theilmbh/RPiOperant/README.md

# RPiOperant
Design files for Raspberry Pi based operant conditioning system
