theilmbh/RPiOperant/panels/BackPanelRevF.pdf

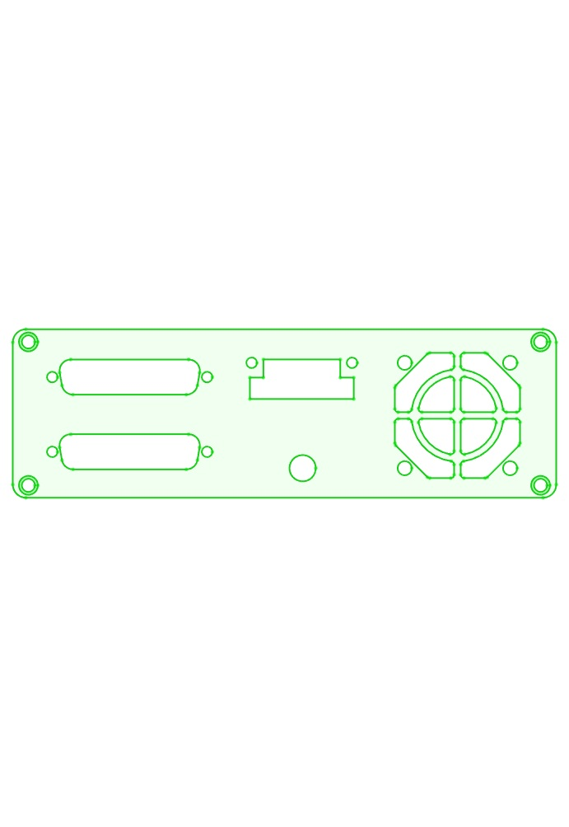
[picture p1: page 1]
