theilmbh/RPiOperant/panels/FrontPanelRevF.pdf

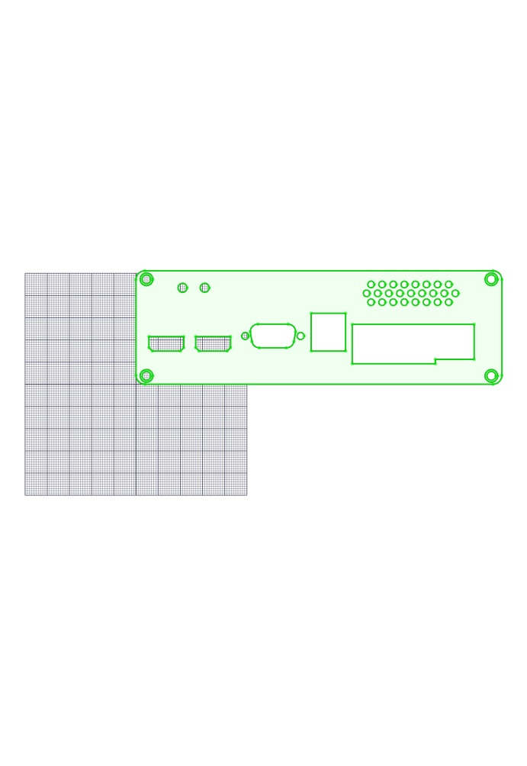
[picture p2: page 1]
