theilmbh/RPiOperant/panels/BackPanelRevF.iges

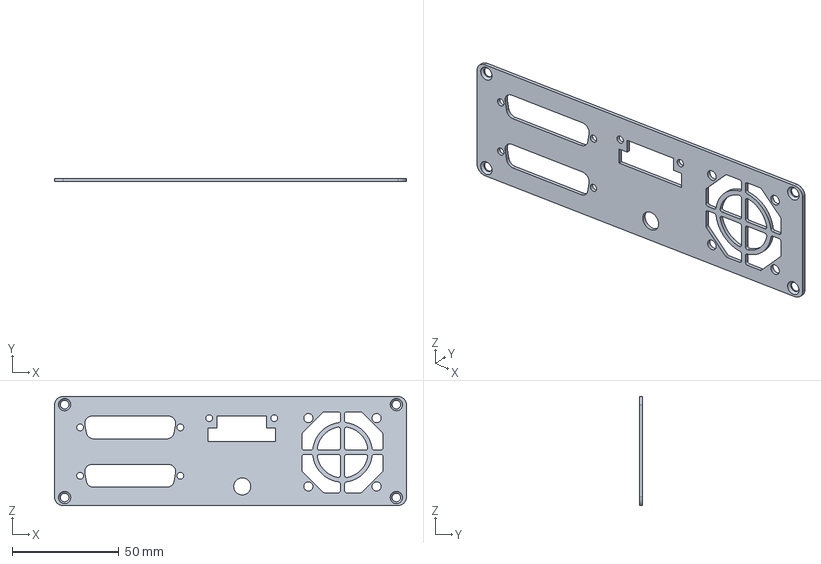
[picture p3: CAD file, 2018-11-16]
panels/BackPanelRevF.iges
165.0 x 1.50 x 51.1 mm
