theilmbh/RPiOperant/panels/FrontPanelRevF.iges

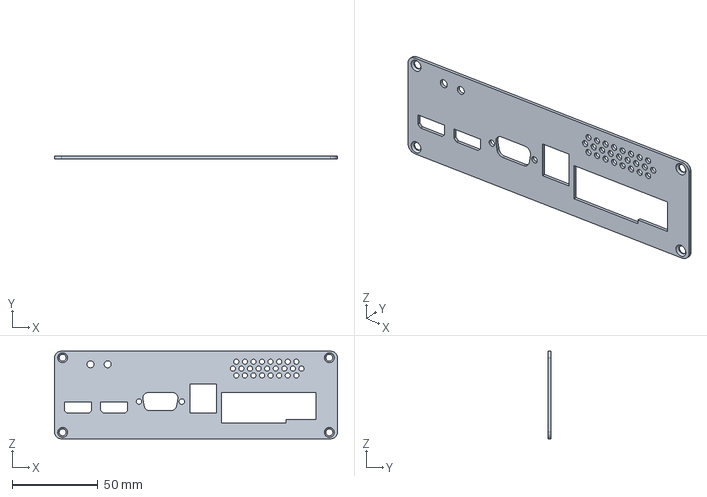
[picture p4: CAD file, 2018-11-16]
panels/FrontPanelRevF.iges
165.0 x 1.50 x 51.1 mm
