theilmbh/RPiOperant/(list of files, cad)

Other CAD files:
panels/RPiOperantFrontPanelRevF.fcstd
panels/RPiOperantBackPanelRevF.fcstd
panels/RPiOperantFrontPanelRevE.fcstd
panels/RPiOperantBackPanelRevE.fcstd
panels/RPiOperantBackPanelRevE.iges
panels/RPiOperantFrontPanelRevE.iges
