theilmbh/RPiOperant/(threads)

Thread 1 (2019-01-18):

Possible wrong item

dbals, 2019-01-18:
In the Digi-Key Cart

13	2	445-173377-1-ND	FG24X7R1H224KNT06	CAP CER 0.22UF 50V X7R RADIAL

I believe it should be:  qty 2 ‎490-11888-ND   RCER71H106MWK1H03B CAP CER 10UF 50V X7R RADIAL
