theilmbh/RPiOperant/schematics/mainboard/RPiOperant.brd

## EAGLE design schematics/mainboard/RPiOperant.brd (2018-11-14)

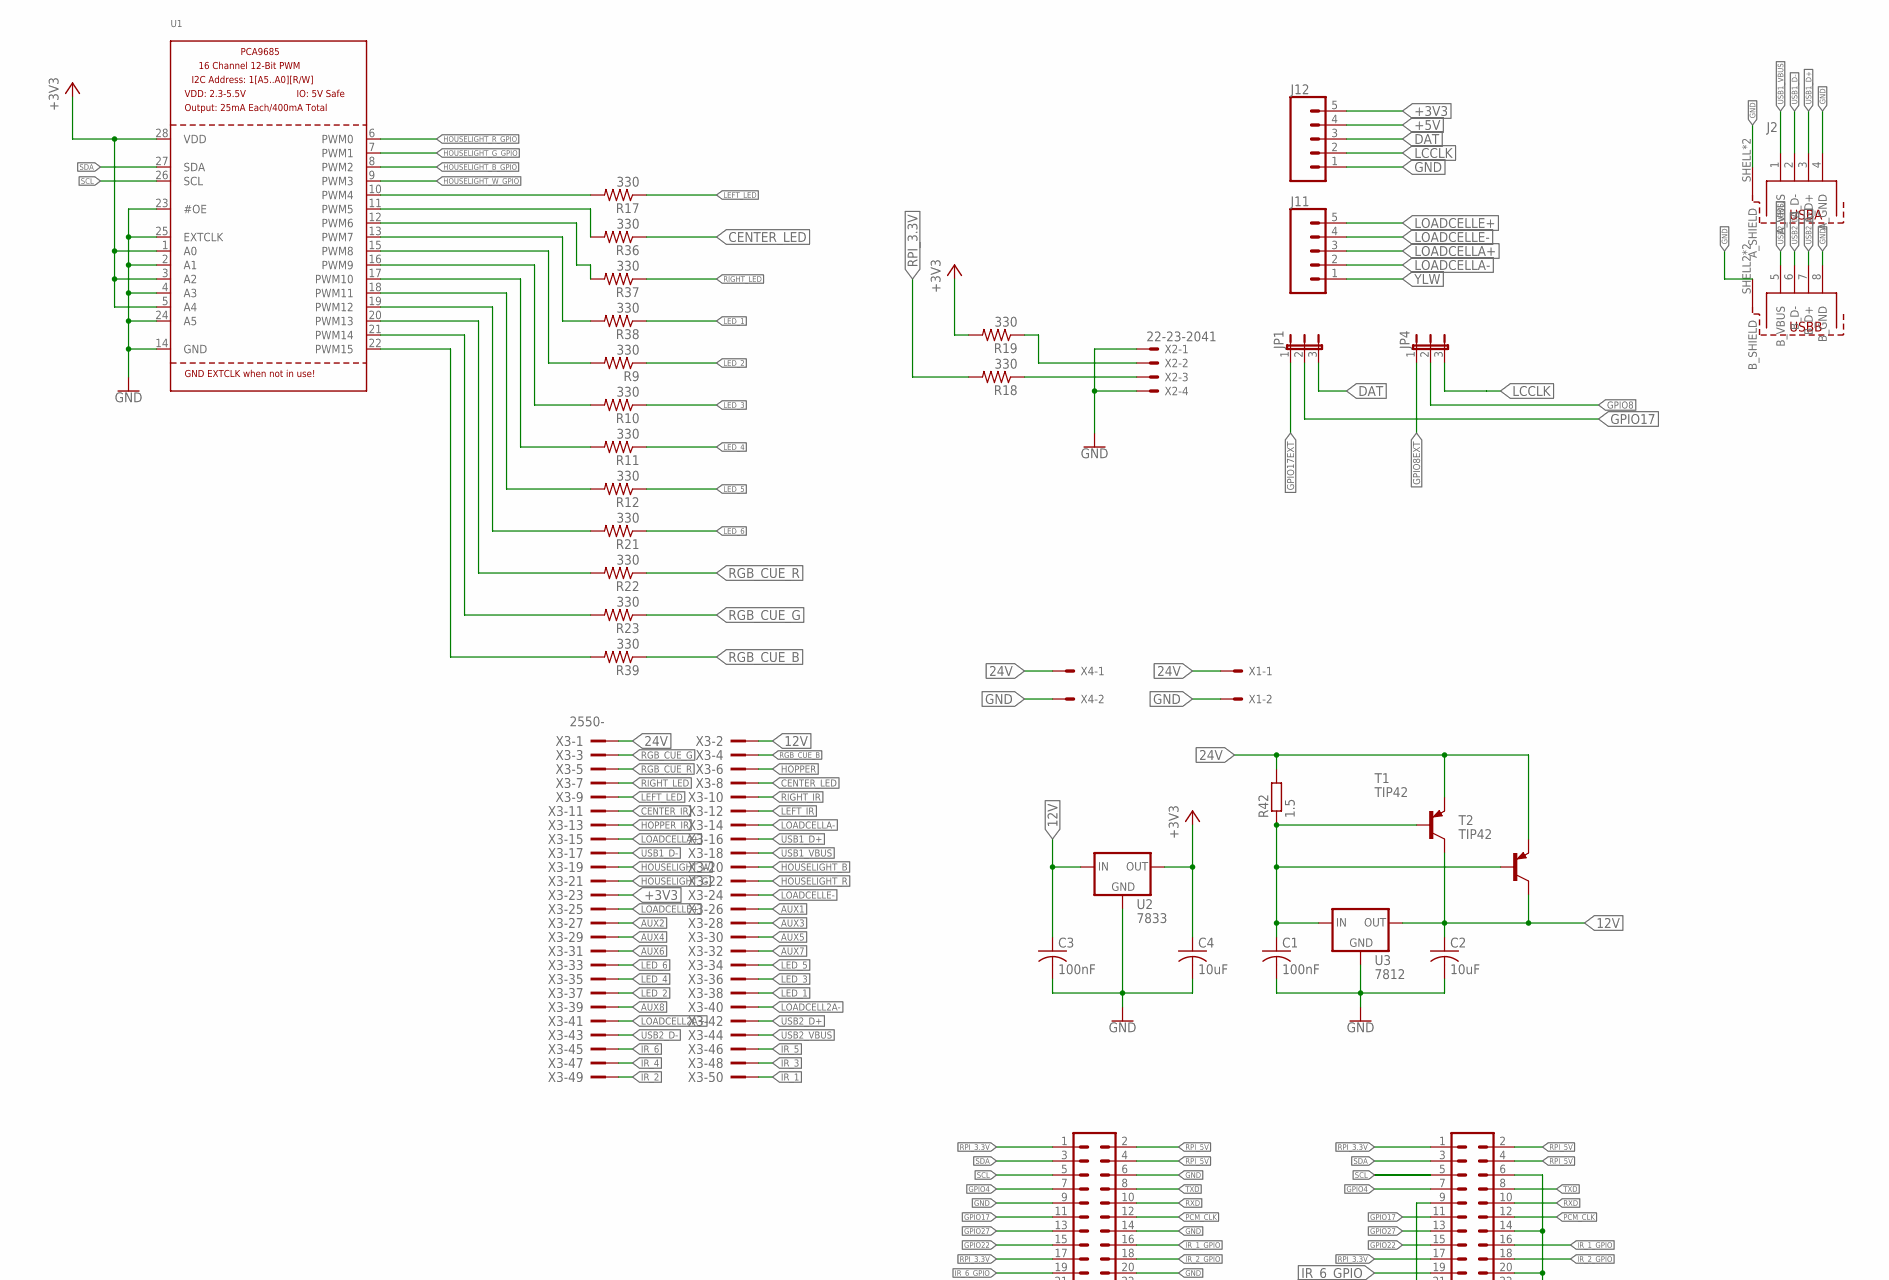
[picture p12: schematic RPiOperant.sch, sheet 1, part in row 1, column 1]

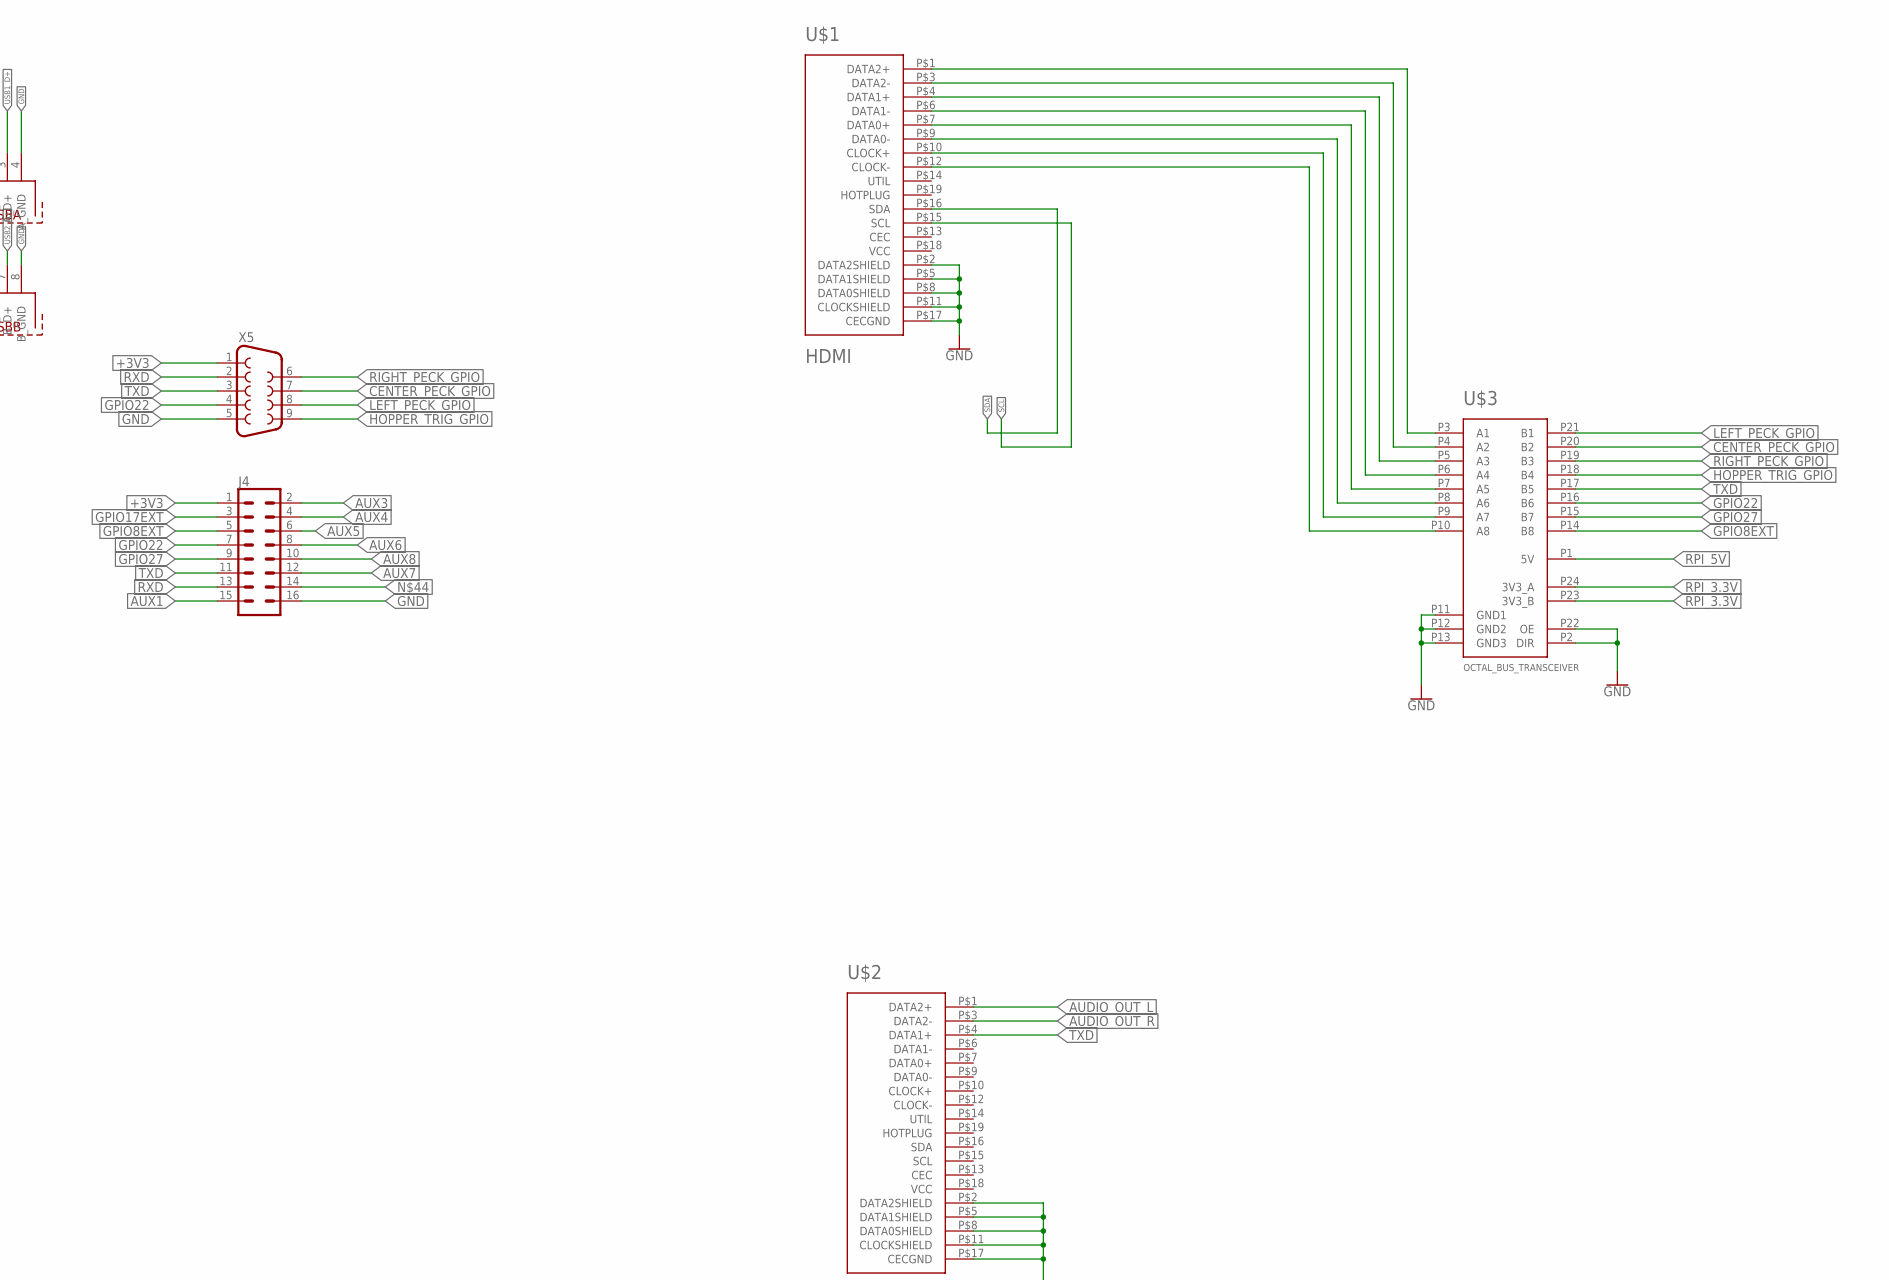
[picture p13: schematic RPiOperant.sch, sheet 1, part in row 1, column 2]

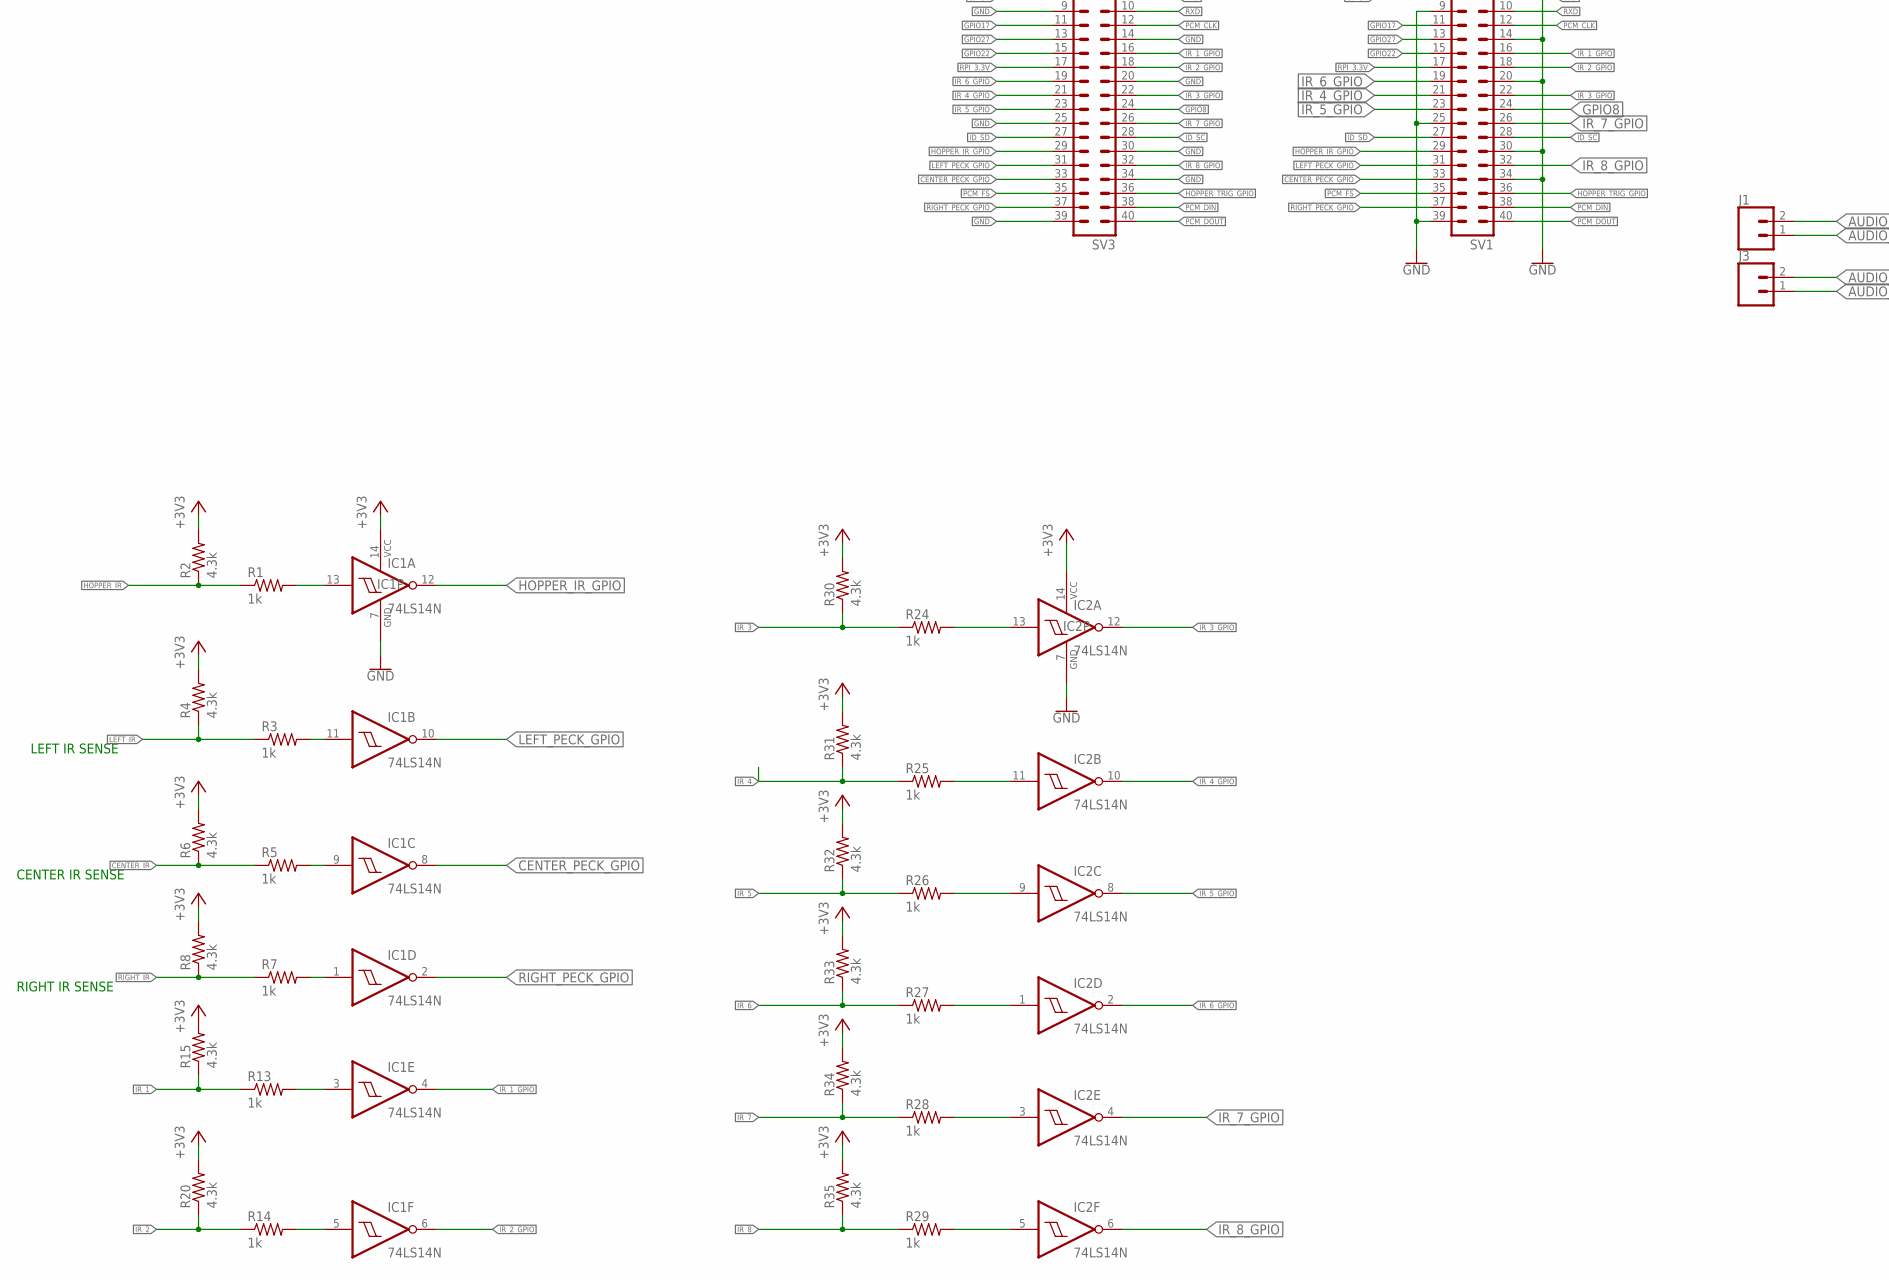
[picture p14: schematic RPiOperant.sch, sheet 1, part in row 2, column 1]

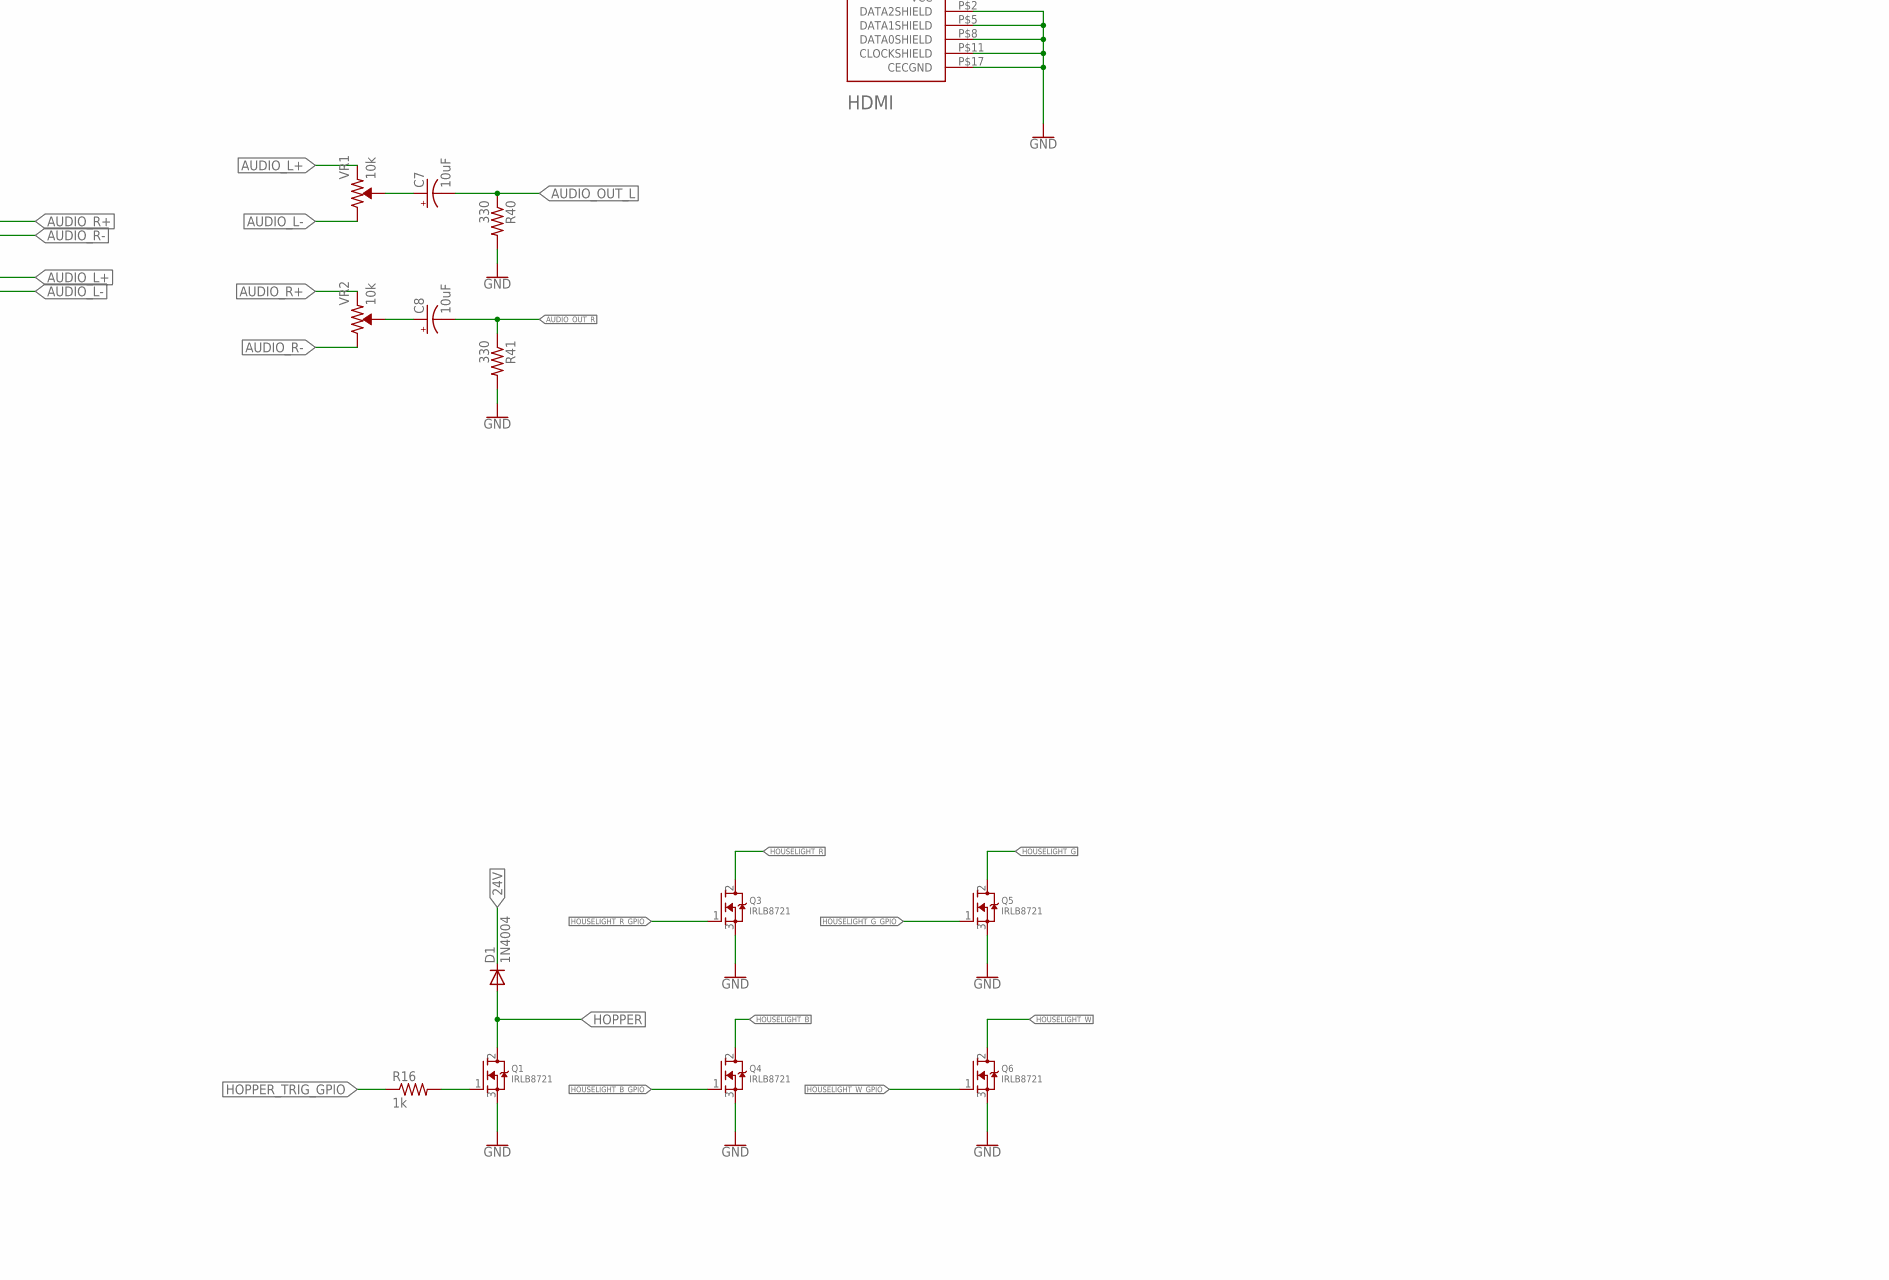
[picture p15: schematic RPiOperant.sch, sheet 1, part in row 2, column 2]

Parts:
C1, C3: 100nF; C050-025X075
C2, C4: 10uF; C050-025X075
C7, C8: 10uF; CPOL-RADIAL-2.5MM-5MM
D1: 1N4004; DO41-10
IC1, IC2: 74LS14N; DIL14
J1, J3: CONN_02POLAR_LOCK; MOLEX-1X2_LOCK
J2: 61400826021
J4: CONN_08X2; 2X8
J11, J12: CONN_05; 1X05
JP1, JP4: JP2E; JP2
Q1, Q3, Q4, Q5, Q6: IRLB8721; TO220V
R1, R3, R5, R7, R13, R14, R16, R24, R25, R26, R27, R28, R29: 1k; 0207/7
R2, R4, R6, R8, R15, R20, R30, R31, R32, R33, R34, R35: 4.3k; 0207/7
R9, R10, R11, R12, R17, R18, R19, R21, R22, R23, R36, R37, R38, R39, R40, R41: 330; 0207/7
R42: 1.5; 0411/15
SV1, SV3: MA20-2
T1, T2: TIP42; TO220V
U1: PCA9685; TSSOP28
U2: 7833; TO220-IGO
U3: 7812; TO220-IGO
U$1, U$2: HDMI; HDMI_A
U$3: OCTAL_BUS_TRANSCEIVER; TSSOP-24
VR1, VR2: 10k; TRIMPOT-PTH-3386U
X1, X4: KK-156-2
X2: 22-23-2041
X3: 2550-; PAK100/2500-50
X5: F09HP

Connections:
12V: C2.1, C3.1, T1.2 (C), T2.2 (C), U2.IN, U3.OUT, X3.2
24V: D1.C, R42.2, T1.3 (E), T2.3 (E), X1.1, X3.1, X4.1
+3V3: C4.1, IC1.14 (VCC), IC2.14 (VCC), J4.1, J12.5, R2.2, R4.2, R6.2, R8.2, R15.2, R19.2, R20.2, R30.2, R31.2, R32.2, R33.2, R34.2, R35.2, U1.1 (A0), U1.3 (A2), U1.5 (A4), U1.28 (VDD), U2.OUT, X3.23, X5.1
+5V: J12.4
AUDIO_L+: J3.2, VR1.1 (CCW)
AUDIO_L-: J3.1, VR1.3 (CW)
AUDIO_OUT_L: C7.2 (-), R40.1, U$2.P$1 (DATA2+)
AUDIO_OUT_R: C8.2 (-), R41.1, U$2.P$3 (DATA2-)
AUDIO_R+: J1.2, VR2.1 (CCW)
AUDIO_R-: J1.1, VR2.3 (CW)
AUX1: J4.15, X3.26
AUX2: X3.27
AUX3: J4.2, X3.28
AUX4: J4.4, X3.29
AUX5: J4.6, X3.30
AUX6: J4.8, X3.31
AUX7: J4.12, X3.32
AUX8: J4.10, X3.39
CENTER_IR: R5.1, R6.1, X3.11
CENTER_LED: R36.1, X3.8
CENTER_PECK_GPIO: IC1.8 (O), SV1.33, SV3.33, U$3.P20 (B2), X5.7
DAT: J12.3, JP1.3
GND: C1.2, C2.2, C3.2, C4.2, IC1.7 (GND), IC2.7 (GND), J2.4 (A_GND), J2.8 (B_GND), J2.SHELL (A_SHIELD), J2.SHELL1 (A_SHIELD), J2.SHELL2 (B_SHIELD), J2.SHELL3 (B_SHIELD), J4.16, J12.1, Q1.3 (S), Q3.3 (S), Q4.3 (S), Q5.3 (S), Q6.3 (S), R40.2, R41.2, SV1.6, SV1.9, SV1.14, SV1.20, SV1.25, SV1.30, SV1.34, SV1.39, SV3.6, SV3.9, SV3.14, SV3.20, SV3.25, SV3.30, SV3.34, SV3.39, U1.2 (A1), U1.4 (A3), U1.14 (GND), U1.23 (#OE), U1.24 (A5), U1.25 (EXTCLK), U2.GND, U3.GND, U$1.P$2 (DATA2SHIELD), U$1.P$5 (DATA1SHIELD), U$1.P$8 (DATA0SHIELD), U$1.P$11 (CLOCKSHIELD), U$1.P$17 (CECGND), U$2.P$2 (DATA2SHIELD), U$2.P$5 (DATA1SHIELD), U$2.P$8 (DATA0SHIELD), U$2.P$11 (CLOCKSHIELD), U$2.P$17 (CECGND), U$3.P2 (DIR), U$3.P11 (GND1), U$3.P12 (GND2), U$3.P13 (GND3), U$3.P22 (OE), X1.2, X2.1, X2.4, X4.2, X5.5
GPIO4: SV1.7, SV3.7
GPIO8: JP4.2, SV1.24, SV3.24
GPIO8EXT: J4.5, JP4.1, U$3.P14 (B8)
GPIO17: JP1.2, SV1.11, SV3.11
GPIO17EXT: J4.3, JP1.1
GPIO22: J4.7, SV1.15, SV3.15, U$3.P16 (B6), X5.4
GPIO27: J4.9, SV1.13, SV3.13, U$3.P15 (B7)
HOPPER: D1.A, Q1.2 (D), X3.6
HOPPER_IR: R1.1, R2.1, X3.13
HOPPER_IR_GPIO: IC1.12 (O), SV1.29, SV3.29
HOPPER_TRIG_GPIO: R16.1, SV1.36, SV3.36, U$3.P18 (B4), X5.9
HOUSELIGHT_B: Q4.2 (D), X3.20
HOUSELIGHT_B_GPIO: Q4.1 (G), U1.8 (PWM2)
HOUSELIGHT_G: Q5.2 (D), X3.21
HOUSELIGHT_G_GPIO: Q5.1 (G), U1.7 (PWM1)
HOUSELIGHT_R: Q3.2 (D), X3.22
HOUSELIGHT_R_GPIO: Q3.1 (G), U1.6 (PWM0)
HOUSELIGHT_W: Q6.2 (D), X3.19
HOUSELIGHT_W_GPIO: Q6.1 (G), U1.9 (PWM3)
ID_SC: SV1.28, SV3.28
ID_SD: SV1.27, SV3.27
IR_1: R13.1, R15.1, X3.50
IR_1_GPIO: IC1.4 (O), SV1.16, SV3.16
IR_2: R14.1, R20.1, X3.49
IR_2_GPIO: IC1.6 (O), SV1.18, SV3.18
IR_3: R24.1, R30.1, X3.48
IR_3_GPIO: IC2.12 (O), SV1.22, SV3.22
IR_4: R25.1, R31.1, X3.47
IR_4_GPIO: IC2.10 (O), SV1.21, SV3.21
IR_5: R26.1, R32.1, X3.46
IR_5_GPIO: IC2.8 (O), SV1.23, SV3.23
IR_6: R27.1, R33.1, X3.45
IR_6_GPIO: IC2.2 (O), SV1.19, SV3.19
IR_7: R28.1, R34.1
IR_7_GPIO: IC2.4 (O), SV1.26, SV3.26
IR_8: R29.1, R35.1
IR_8_GPIO: IC2.6 (O), SV1.32, SV3.32
LCCLK: J12.2, JP4.3
LED_1: R38.1, X3.38
LED_2: R9.1, X3.37
LED_3: R10.1, X3.36
LED_4: R11.1, X3.35
LED_5: R12.1, X3.34
LED_6: R21.1, X3.33
LEFT_IR: R3.1, R4.1, X3.12
LEFT_LED: R17.1, X3.9
LEFT_PECK_GPIO: IC1.10 (O), SV1.31, SV3.31, U$3.P21 (B1), X5.8
LOADCELL2A+: X3.41
LOADCELL2A-: X3.40
LOADCELLA+: J11.3, X3.15
LOADCELLA-: J11.2, X3.14
LOADCELLE+: J11.5, X3.25
LOADCELLE-: J11.4, X3.24
unnamed: IC1.3 (I), R13.2
unnamed: IC1.5 (I), R14.2
unnamed: IC2.13 (I), R24.2
unnamed: IC2.11 (I), R25.2
unnamed: IC2.9 (I), R26.2
unnamed: IC1.13 (I), R1.2
unnamed: IC2.1 (I), R27.2
unnamed: IC1.11 (I), R3.2
unnamed: IC2.3 (I), R28.2
unnamed: IC1.9 (I), R5.2
unnamed: IC2.5 (I), R29.2
unnamed: IC1.1 (I), R7.2
unnamed: R17.2, U1.10 (PWM4)
unnamed: R36.2, U1.11 (PWM5)
unnamed: R37.2, U1.12 (PWM6)
unnamed: R38.2, U1.13 (PWM7)
unnamed: U$1.P$1 (DATA2+), U$3.P3 (A1)
unnamed: U$1.P$3 (DATA2-), U$3.P4 (A2)
unnamed: R22.2, U1.20 (PWM13)
unnamed: R23.2, U1.21 (PWM14)
unnamed: R39.2, U1.22 (PWM15)
unnamed: C1.1, R42.1, T1.1 (B), T2.1 (B), U3.IN
unnamed: Q1.1 (G), R16.2
unnamed: R19.1, X2.2
unnamed: R9.2, U1.15 (PWM8)
unnamed: R10.2, U1.16 (PWM9)
unnamed: R11.2, U1.17 (PWM10)
unnamed: R12.2, U1.18 (PWM11)
unnamed: R21.2, U1.19 (PWM12)
unnamed: R18.1, X2.3
unnamed: U$1.P$4 (DATA1+), U$3.P5 (A3)
unnamed: U$1.P$6 (DATA1-), U$3.P6 (A4)
unnamed: C7.1 (+), VR1.2 (WIPER)
unnamed: C8.1 (+), VR2.2 (WIPER)
unnamed: U$1.P$7 (DATA0+), U$3.P7 (A5)
unnamed: U$1.P$9 (DATA0-), U$3.P8 (A6)
unnamed: U$1.P$10 (CLOCK+), U$3.P9 (A7)
unnamed: U$1.P$12 (CLOCK-), U$3.P10 (A8)
PCM_CLK: SV1.12, SV3.12
PCM_DIN: SV1.38, SV3.38
PCM_DOUT: SV1.40, SV3.40
PCM_FS: SV1.35, SV3.35
RGB_CUE_B: R39.1, X3.4
RGB_CUE_G: R23.1, X3.3
RGB_CUE_R: R22.1, X3.5
RIGHT_IR: R7.1, R8.1, X3.10
RIGHT_LED: R37.1, X3.7
RIGHT_PECK_GPIO: IC1.2 (O), SV1.37, SV3.37, U$3.P19 (B3), X5.6
RPI_3.3V: R18.2, SV1.1, SV1.17, SV3.1, SV3.17, U$3.P23 (3V3_B), U$3.P24 (3V3_A)
RPI_5V: SV1.2, SV1.4, SV3.2, SV3.4, U$3.P1 (5V)
RXD: J4.13, SV1.10, SV3.10, X5.2
SCL: SV1.5, SV3.5, U1.26 (SCL), U$1.P$15 (SCL)
SDA: SV1.3, SV3.3, U1.27 (SDA), U$1.P$16 (SDA)
TXD: J4.11, SV1.8, SV3.8, U$2.P$4 (DATA1+), U$3.P17 (B5), X5.3
USB1_D+: J2.3 (A_D+), X3.16
USB1_D-: J2.2 (A_D-), X3.17
USB1_VBUS: J2.1 (A_VBUS), X3.18
USB2_D+: J2.7 (B_D+), X3.42
USB2_D-: J2.6 (B_D-), X3.43
USB2_VBUS: J2.5 (B_VBUS), X3.44
YLW: J11.1

Notes on the sheet:
LEFT IR SENSE
CENTER IR SENSE
RIGHT IR SENSE

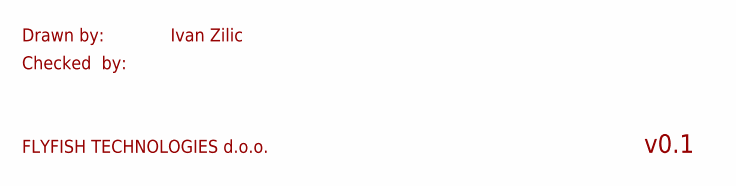
[picture p16: schematic RPiOperant.sch, sheet 2]

Notes on the sheet:
Drawn by:
Checked by:
FLYFISH TECHNOLOGIES d.o.o.
Ivan Zilic
v0.1

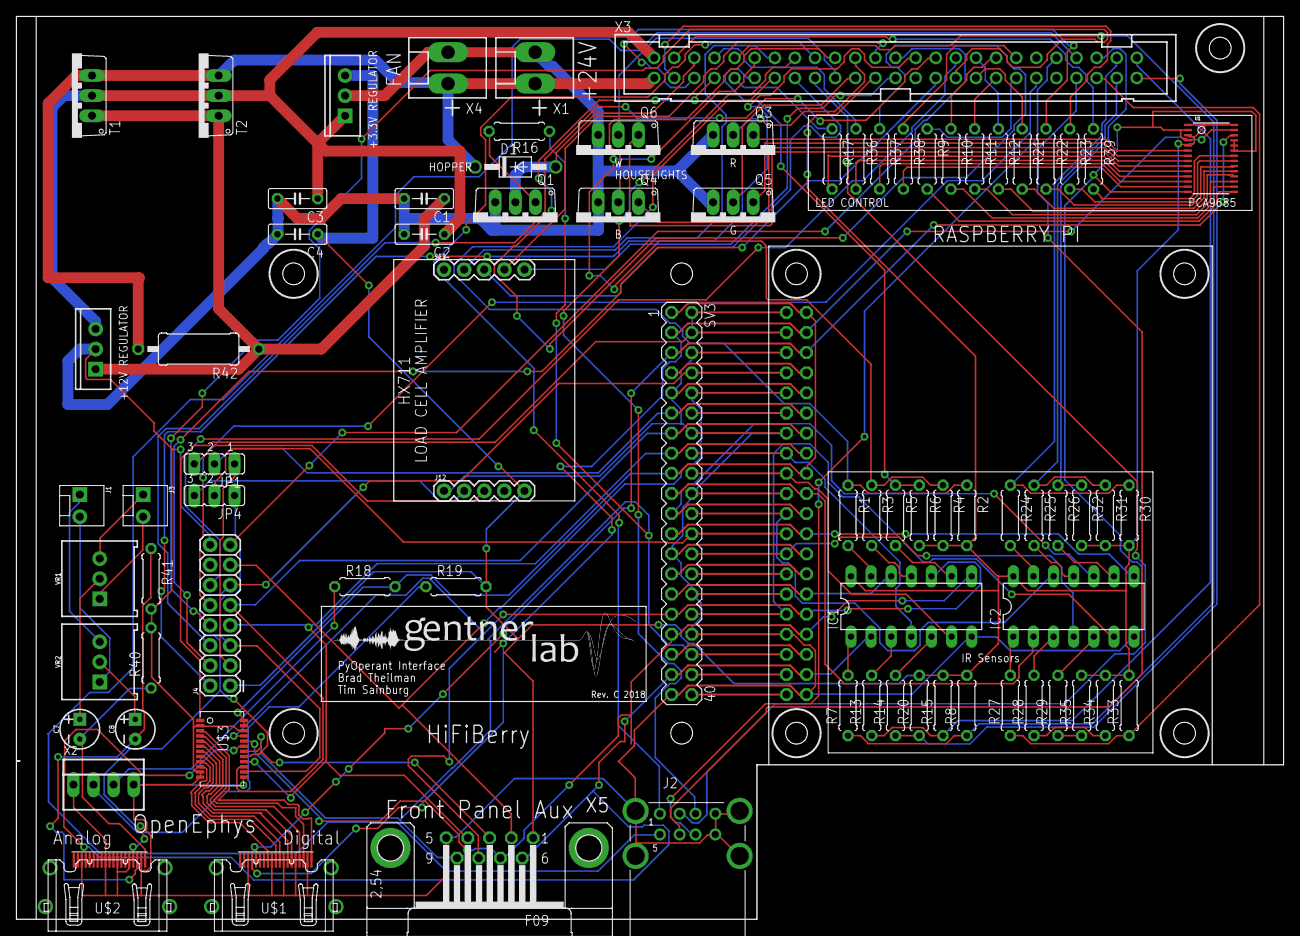
[picture p17: board RPiOperant.brd from above]

Board: 2 copper layers, 160.0 x 114.0 mm, 81 parts (1 on the bottom side), 132 nets.
