theilmbh/RPiOperant/schematics/breakoutboard/RPiOperantBreakout.brd

## EAGLE design schematics/breakoutboard/RPiOperantBreakout.brd (2018-11-14)

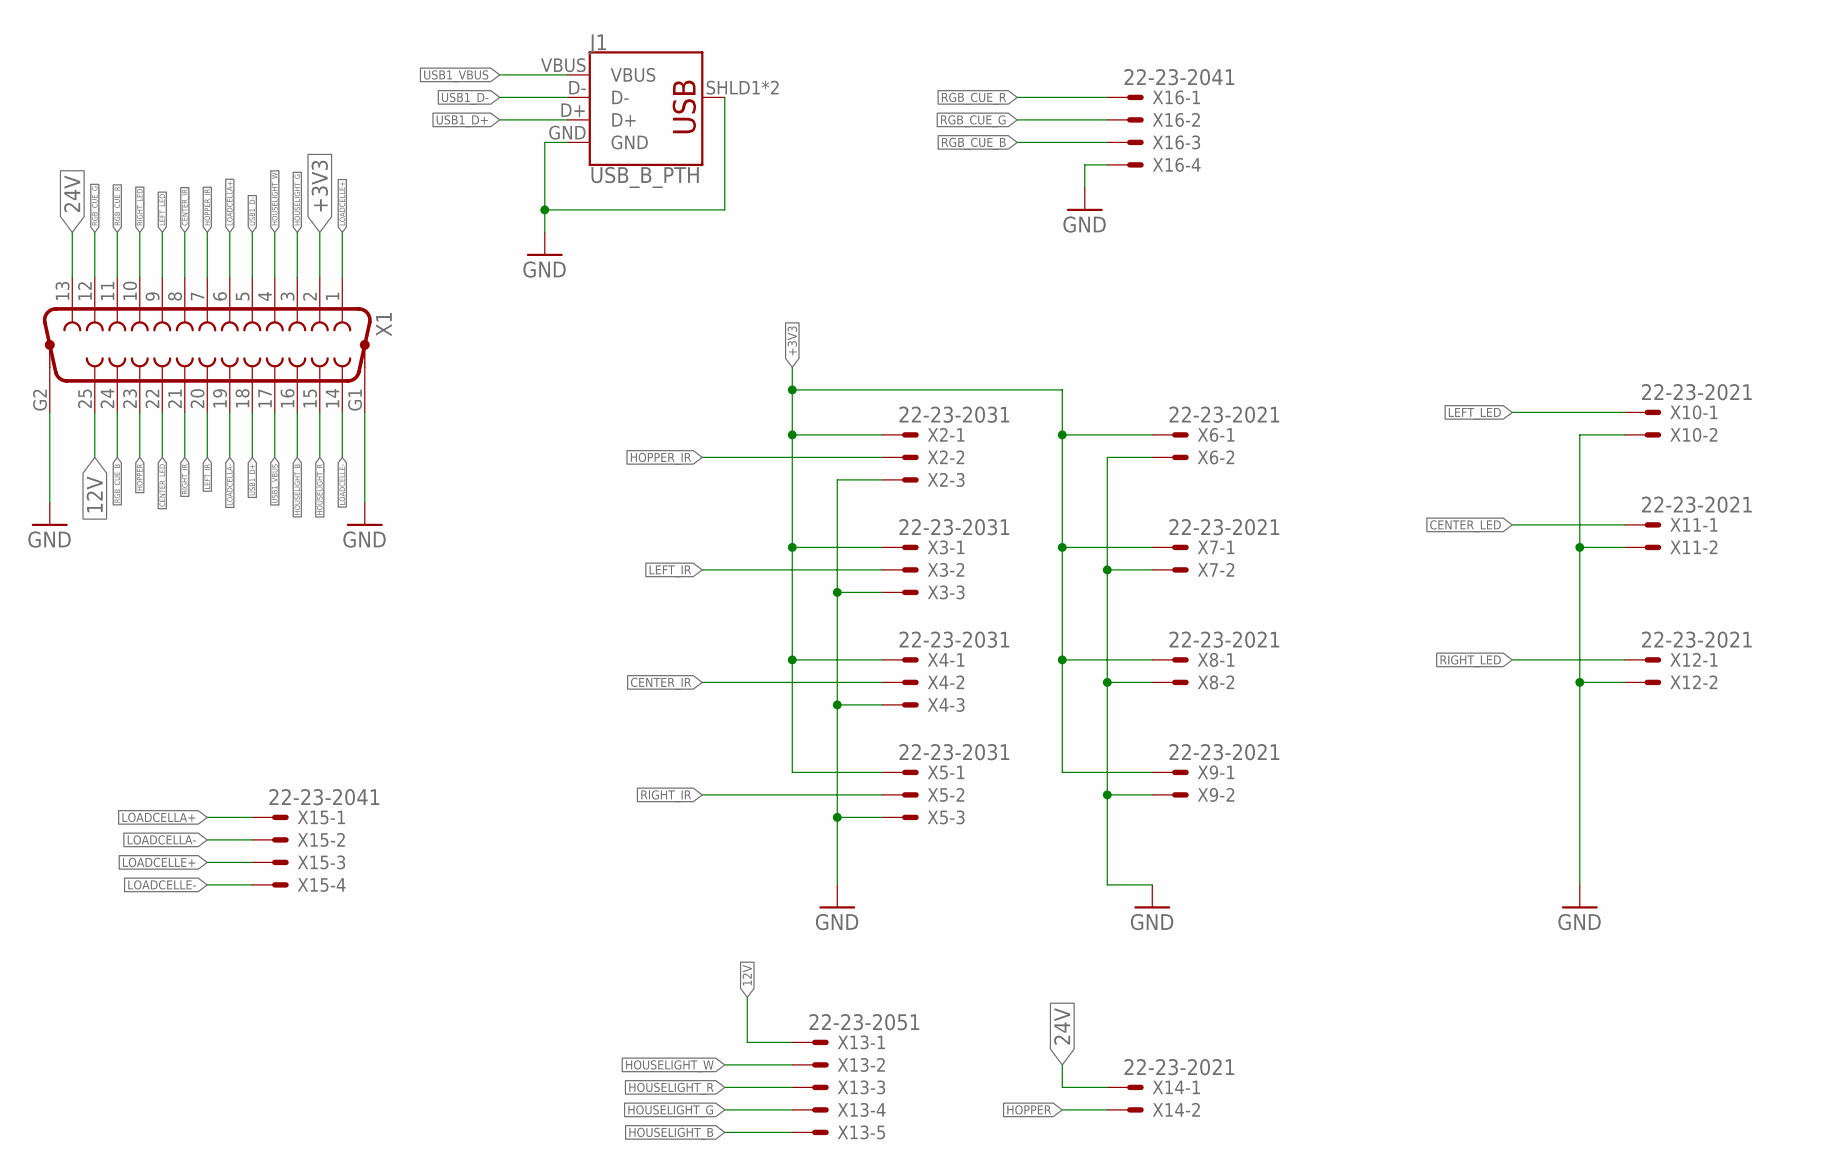
[picture p18: schematic RPiOperantBreakout.sch]

Parts:
J1: USB_B_PTH; USB-B-PTH
X1: F25HP
X2, X3, X4, X5: 22-23-2031
X6, X7, X8, X9, X10, X11, X12, X14: 22-23-2021
X13: 22-23-2051
X15, X16: 22-23-2041

Connections:
12V: X1.25, X13.1
24V: X1.13, X14.1
+3V3: X1.2, X2.1, X3.1, X4.1, X5.1, X6.1, X7.1, X8.1, X9.1
CENTER_IR: X1.8, X4.2
CENTER_LED: X1.22, X11.1
GND: J1.GND, J1.SHLD1 (SHIELD), J1.SHLD2 (SHIELD), X1.G1, X1.G2, X2.3, X3.3, X4.3, X5.3, X6.2, X7.2, X8.2, X9.2, X10.2, X11.2, X12.2, X16.4
HOPPER: X1.23, X14.2
HOPPER_IR: X1.7, X2.2
HOUSELIGHT_B: X1.16, X13.5
HOUSELIGHT_G: X1.3, X13.4
HOUSELIGHT_R: X1.15, X13.3
HOUSELIGHT_W: X1.4, X13.2
LEFT_IR: X1.20, X3.2
LEFT_LED: X1.9, X10.1
LOADCELLA+: X1.6, X15.1
LOADCELLA-: X1.19, X15.2
LOADCELLE+: X1.1, X15.3
LOADCELLE-: X1.14, X15.4
RGB_CUE_B: X1.24, X16.3
RGB_CUE_G: X1.12, X16.2
RGB_CUE_R: X1.11, X16.1
RIGHT_IR: X1.21, X5.2
RIGHT_LED: X1.10, X12.1
USB1_D+: J1.D+, X1.18
USB1_D-: J1.D-, X1.5
USB1_VBUS: J1.VBUS, X1.17

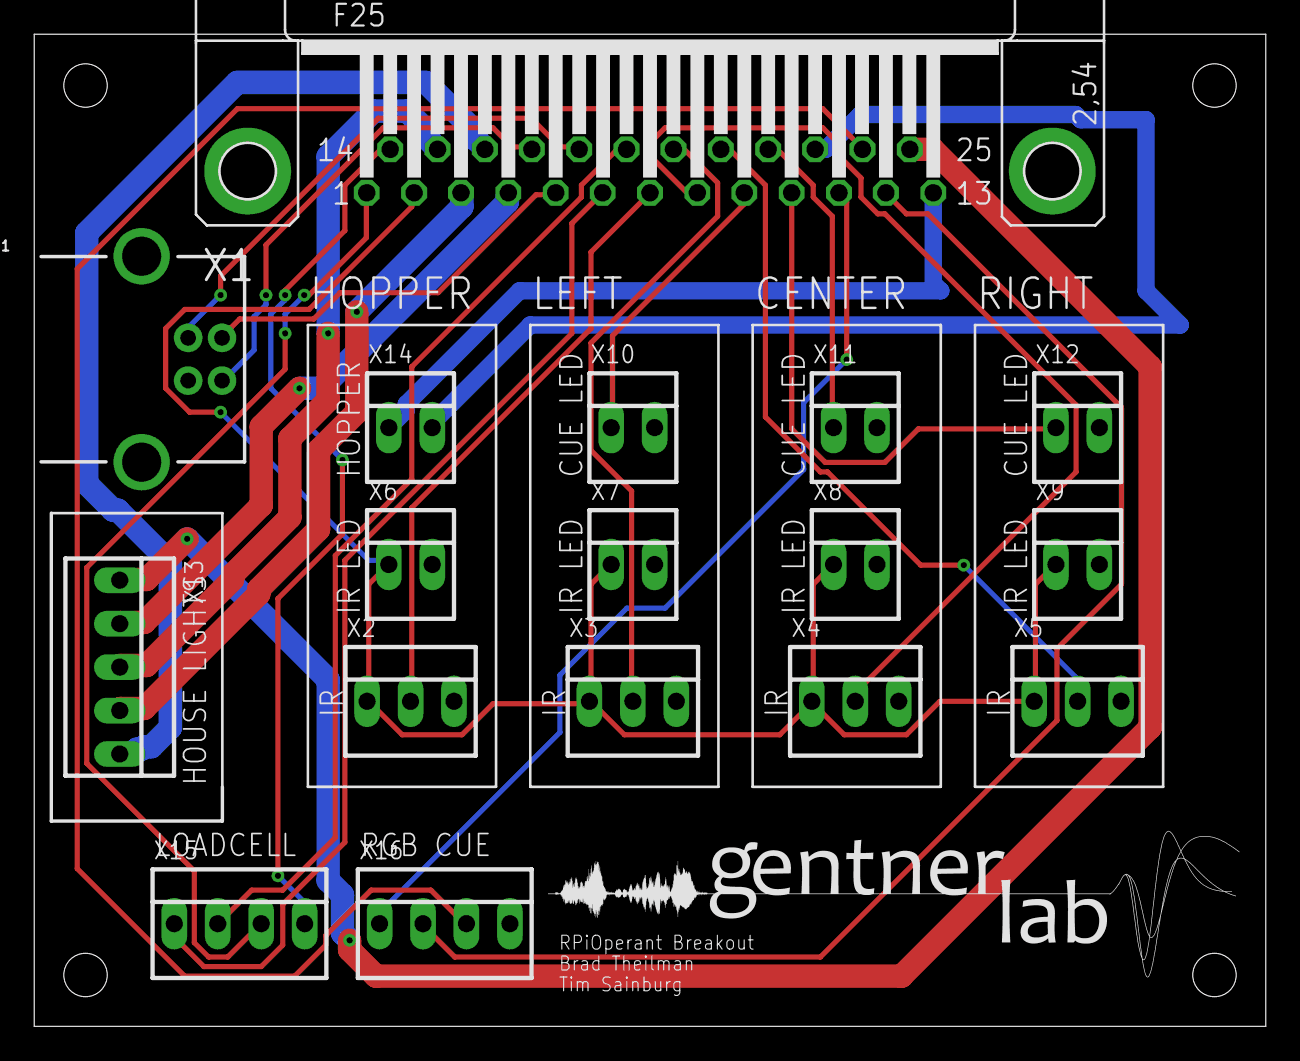
[picture p19: board RPiOperantBreakout.brd from above]

Board: 2 copper layers, 72.0 x 58.0 mm, 17 parts (0 on the bottom side), 26 nets.
