theilmbh/RPiOperant/(commit log)

2018-11-14 Added schematics, pcbs and gerbers
    [RPiOperant.brd, RPiOperant.sch, RPiOperantBreakout.brd, RPiOperantBreakout.sch]
2018-11-14 added digikey cart
    [DigikeyCart.csv]
2018-11-14 updated cart
    [DigikeyCart.csv]
2018-11-14 other parts
    [OtherElectronicParts.csv]
2018-11-14 added panels
    [RPiOperantBackPanelRevE.fcstd, RPiOperantFrontPanelRevE.fcstd]
2018-11-14 update panels
    [RPiOperantBackPanelRevE.fcstd, RPiOperantBackPanelRevE.iges, RPiOperantFrontPanelRevE.iges]
2018-11-16 new (final) panel designs
    [BackPanelRevF.iges, FrontPanelRevF.iges, RPiOperantBackPanelRevF.fcstd, RPiOperantFrontPanelRevE.fcstd, RPiOperantFrontPanelRevF.fcstd]
